Teivaz/smartknob/(commit log)

2022-08-08 Updated to Kicad 6 Replaced following parts: SN74LV1T34DBV -> SN74LV1T32DBVRG4 AP2114HA-3.3 -> NCP11171IST33T3G
    [view_base.kicad_pcb, view_base.kicad_sch, view_base.sch, view_screen.kicad_pcb]
2022-08-28 Added DNP resistor to bypass level shift
    [view_base.kicad_pcb, view_base.kicad_sch]
2022-08-28 Updated text
    [view_base.kicad_pcb]
2022-08-29 Bumped version of kicad
2022-08-29 Fixed DRC violations
    [view_base.kicad_pcb]
2022-08-29 Updated libraries after migration to kicad 6 Updated gitignore after migration to kicad 6
    [view_base.kicad_pcb, view_base.kicad_sch]
2022-08-29 Updated view_screen to kicad 6
    [view_screen.kicad_pcb, view_screen.kicad_sch, view_screen.sch]
2022-09-11 Replaced motor connector with molex picolock
    [view_base.kicad_pcb, view_base.kicad_sch]
